bhamla-lab/LoCHAid-2020-PLOS-ONE/Fixed Schematic.pdf

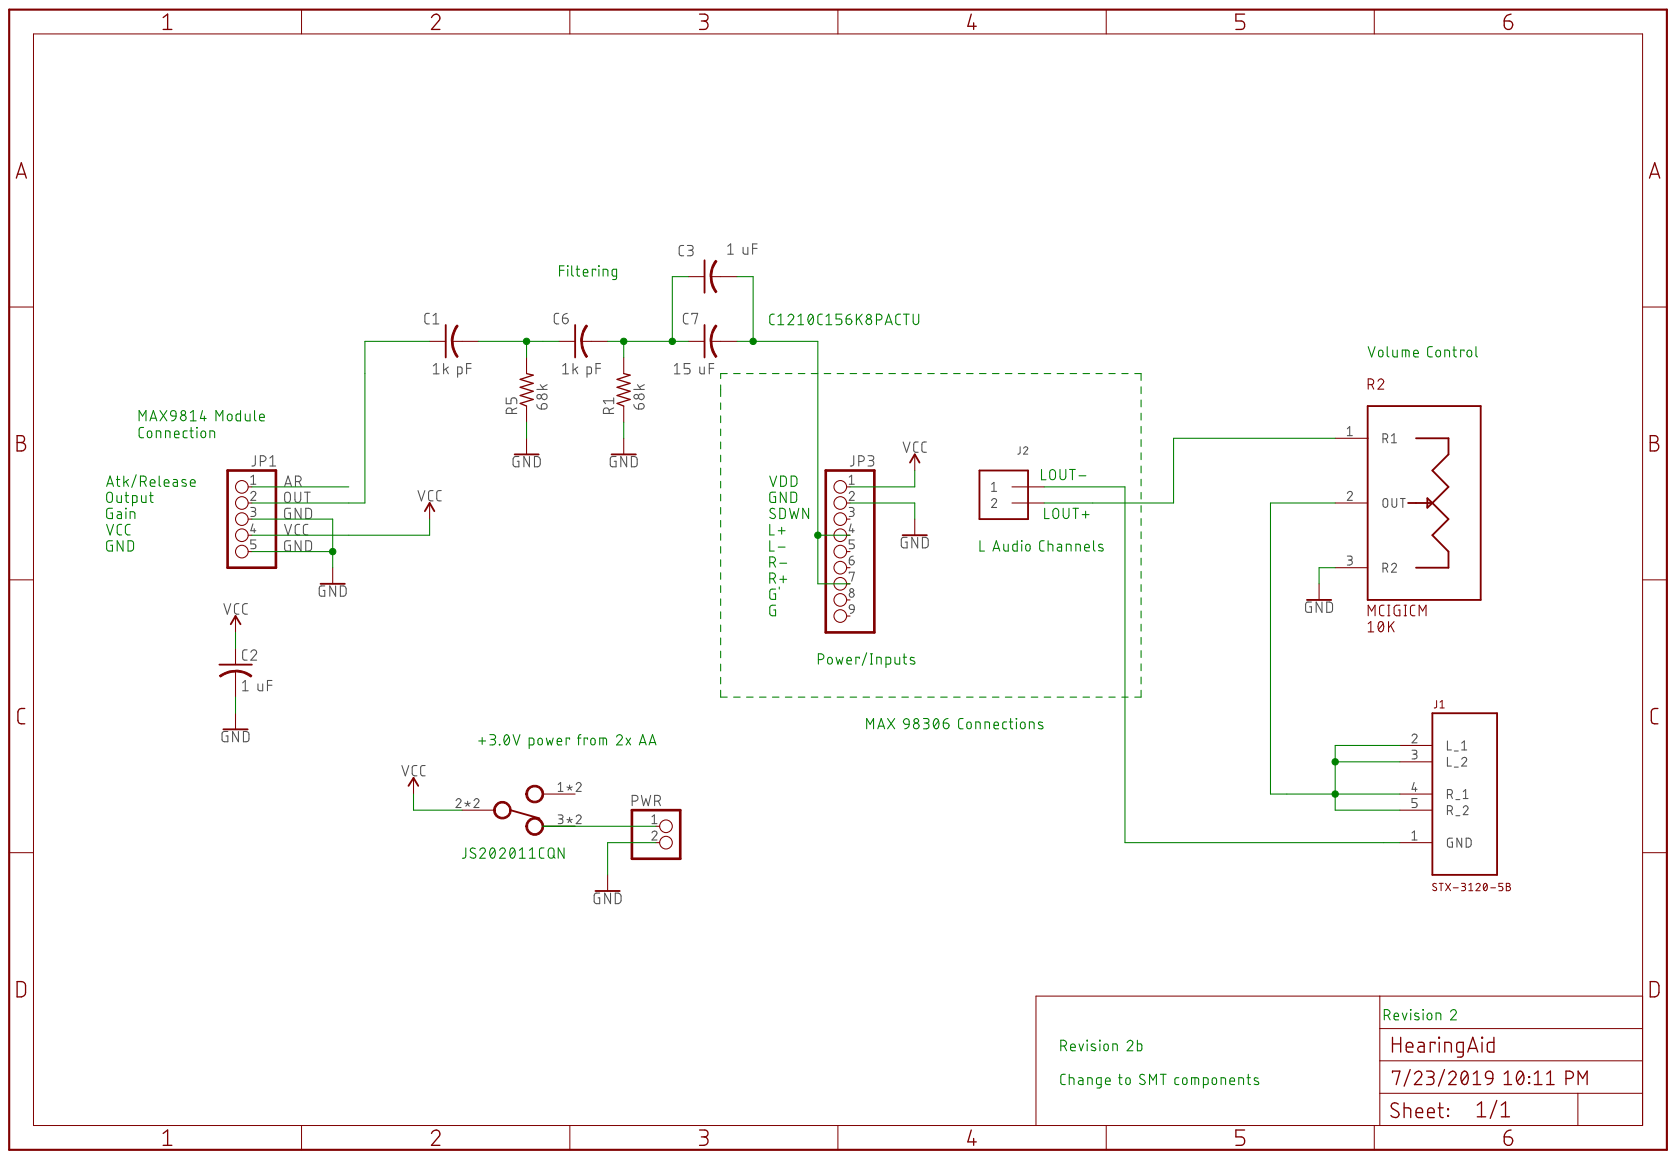
[picture p1: page 1]
