bhamla-lab/LoCHAid-2020-PLOS-ONE/hearingamp_PAM_v2/hearingamp_PAM_v2.sch

## EAGLE design hearingamp_PAM_v2/hearingamp_PAM_v2.sch (2021-12-29)

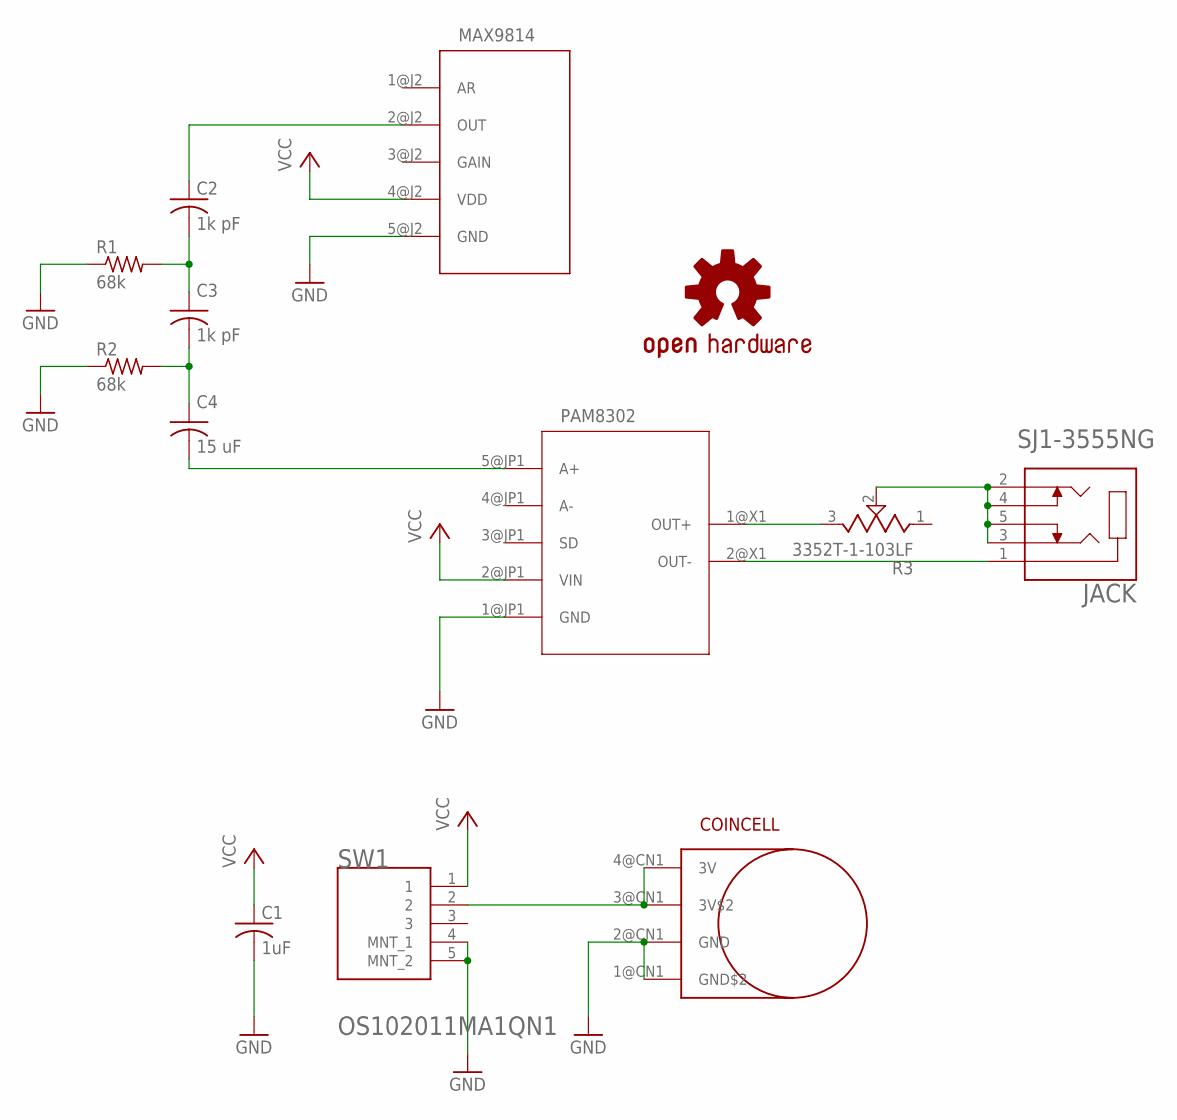
[picture p2: schematic hearingamp_PAM_v2.sch]

Parts:
C1: 1uF; C050-025X075
C2, C3: 1k pF; C050-025X075
C4: 15 uF; C050-025X075
COINCELL: 20MMCOINCELL; CN1_COIN20MM
JACK: SJ1-3555NG; CUI_SJ1-3555NG
LOGO1: OSHW-LOGOL; OSHW-LOGO-L
MAX9814: ADAFRUIT_MAX9814
PAM1: ADAFRUIT_PAM8302A; ADAFRUIT_PAM8302
R1, R2: 68k; 0204/7
R3: 3352T-1-103LF; TRIM_3352T-1-103LF
SW1: C&K_OS102011MA1QN1C&K_OS102011MA1QN1_0_0; C&K_OS102011MA1QN1_0

Connections:
GND: C1.2, COINCELL.1@CN1 (GND$2), COINCELL.2@CN1 (GND), MAX9814.5@J2 (GND), PAM1.1@JP1 (GND), R1.1, R2.1, SW1.4 (MNT_1), SW1.5 (MNT_2)
unnamed: PAM1.1@X1 (OUT+), R3.3 (CW)
unnamed: C3.2, C4.1, R2.2
unnamed: JACK.2, JACK.3, JACK.4, JACK.5, R3.2 (WIPER)
unnamed: COINCELL.3@CN1 (3V$2), COINCELL.4@CN1 (3V), SW1.2
unnamed: C4.2, PAM1.5@JP1 (A+)
unnamed: C2.2, C3.1, R1.2
unnamed: JACK.1, PAM1.2@X1 (OUT-)
unnamed: C2.1, MAX9814.2@J2 (OUT)
VCC: C1.1, MAX9814.4@J2 (VDD), PAM1.2@JP1 (VIN), SW1.1

Notes on the sheet:
PAM8302
